LEIwaw-0/smart-parcel-locker/firmware/bsp/tft_lcd/hzfont.c

#include "hzfont.h"

/* 16x16 Chinese bitmap font generated from SimSun.
   Format: 16 rows x 2 bytes/row, MSB first, bit=1 = foreground pixel.
   Array sorted by gbk_code ascending for binary search. */
const HZFont_t HZFont[] = {
    {0xA1E6, {0x60,0x00,0x91,0xF4,0x96,0x0C,0x6C,0x04,0x08,0x04,0x18,0x00,0x18,0x00,0x18,0x00,0x18,0x00,0x18,0x00,0x18,0x00,0x08,0x00,0x0C,0x04,0x06,0x08,0x01,0xF0,0x00,0x00}}, /* gbk=0xA1E6 */
    {0xA3AC, {0x00,0x00,0x00,0x00,0x00,0x00,0x00,0x00,0x00,0x00,0x00,0x00,0x00,0x00,0x00,0x00,0x00,0x00,0x00,0x00,0x00,0x00,0x30,0x00,0x30,0x00,0x10,0x00,0x20,0x00,0x00,0x00}}, /* gbk=0xA3AC */
    {0xB0B4, {0x10,0x40,0x10,0x20,0x10,0x20,0x13,0xFE,0xFA,0x02,0x14,0x44,0x10,0x40,0x1B,0xFE,0x30,0x88,0xD0,0x88,0x11,0x08,0x10,0xD0,0x10,0x20,0x10,0x50,0x50,0x88,0x23,0x04}}, /* gbk=0xB0B4 */
    {0xB0CB, {0x00,0x00,0x00,0x40,0x04,0x40,0x04,0x40,0x04,0x40,0x04,0x40,0x04,0x40,0x04,0x20,0x08,0x20,0x08,0x20,0x08,0x10,0x10,0x10,0x10,0x08,0x20,0x08,0x20,0x04,0x40,0x02}}, /* gbk=0xB0CB */
    {0xB0D7, {0x01,0x00,0x02,0x00,0x04,0x00,0x3F,0xF8,0x20,0x08,0x20,0x08,0x20,0x08,0x20,0x08,0x3F,0xF8,0x20,0x08,0x20,0x08,0x20,0x08,0x20,0x08,0x20,0x08,0x3F,0xF8,0x20,0x08}}, /* gbk=0xB0D7 */
    {0xB0DC, {0x00,0x40,0x7C,0x40,0x44,0x40,0x54,0x80,0x54,0xFE,0x55,0x08,0x56,0x88,0x54,0x88,0x54,0x88,0x54,0x50,0x54,0x50,0x10,0x20,0x28,0x50,0x24,0x88,0x45,0x04,0x82,0x02}}, /* gbk=0xB0DC */
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
    int lo = 0, hi = HZFont_Count - 1;
    while (lo <= hi) {
        int mid = (lo + hi) / 2;
        if (HZFont[mid].gbk_code == gbk_code) return HZFont[mid].bits;
        if (HZFont[mid].gbk_code < gbk_code) lo = mid + 1;
        else hi = mid - 1;
    }
    return 0;
}
