LEIwaw-0/smart-parcel-locker/firmware/app/app_cloud.c

/******************************************************
**  app_cloud.c - TCP link to the locker server (port 8090).
**
**  Split out of the monolithic main.c; the parsing is unchanged.  Only
**  the transport moved: every uplink line is posted to the link task
**  instead of being written to the ESP8266 from here, and the door mask
**  now comes from the door task's g_door_fb snapshot.
******************************************************/
#include "app_cloud.h"
#include "app_ctx.h"
#include "app_rtos.h"
#include "app_door.h"     /* DoOpenBox */
#include "app_ui.h"       /* StatusBar_Set, PickupDone_Draw */
#include "app_voice.h"    /* Chat_HandleResponse */
#include "codebox.h"
#include "esp8266.h"
#include "lock.h"
#include <stdio.h>
#include <string.h>

void Cloud_Queue(const char *line)
{
    App_LinkPost(line);
}

static void Cloud_SendStatus(void)
{
    char line[160];
    char snap[80];
    char cbuf[8];
    uint8_t i, o = 0, occ = 0, door = 0;
    CodeEntry e;

    for (i = 1; i <= BOX_COUNT; i++)
    {
        if (CodeBox_GetEntry(i, &e))
        {
            occ |= (uint8_t)(1u << (i - 1));
            memcpy(cbuf, e.code, CODE_LEN);
            cbuf[CODE_LEN] = 0;
        }
        else
        {
            strcpy(cbuf, "------");
        }
        /* 门磁: 1=开. I2C读失败按“关”处理, 避免误报门开 */
        if ((g_door_fb >> (i - 1)) & 1u) door |= (uint8_t)(1u << (i - 1));
        if (i > 1) snap[o++] = '|';
        o += (uint8_t)sprintf(snap + o, "%d:%s", (int)i, cbuf);
    }
    snap[o] = 0;
    sprintf(line, "STATUS %d %d %s", (int)occ, (int)door, snap);
    Cloud_Queue(line);
    printf("[CLOUD] %s\r\n", line);
}

static void Cloud_RemoteOpen(uint8_t box)
{
    s_res_box  = box;
    s_res_ok   = 1;
    DoOpenBox(box, SRC_TOUCH, 3);
    StatusBar_Set(SRC_TOUCH, box, "\xD2\xD1\xBF\xAA\xCB\xF8");   /* 已开锁: all glyphs in HZFont */
    s_overlay   = 0;
    s_chat_mode = 0;
    s_state = ST_PICKUP_DONE;
    PickupDone_Draw();
    printf("[CLOUD] remote open box %d\r\n", (int)box);
}

void Cloud_HandleLine(const char *line)
{
    const char *p;
    uint8_t kind;      /* 1=OPEN/UNLOCK, 2=SET, 3=CLEAR */
    int b = 0;

    if (strncmp(line, "AI:", 3) == 0)
    {
        if (s_chat_mode) Chat_HandleResponse(line);
        return;
    }
    if (strncmp(line, "OPEN ", 5) == 0)        { p = line + 5; kind = 1; }
    else if (strncmp(line, "UNLOCK ", 7) == 0) { p = line + 7; kind = 1; }
    else if (strncmp(line, "SET ", 4) == 0)    { p = line + 4; kind = 2; }
    else if (strncmp(line, "CLEAR ", 6) == 0)  { p = line + 6; kind = 3; }
    else { printf("[CLOUD] unknown downlink: %s\r\n", line); return; }

    while (*p >= '0' && *p <= '9') { b = b * 10 + (*p - '0'); p++; }
    if (b < 1 || b > BOX_COUNT) { printf("[CLOUD] bad box: %s\r\n", line); return; }

    if (kind == 2)
    {
        char code[8];
        uint8_t n = 0, i;
        uint8_t cb[CODE_LEN];
        while (*p == ' ') p++;
        while (*p && *p != ' ' && n < CODE_LEN) code[n++] = *p++;
        code[n] = 0;
        if (n != CODE_LEN) { printf("[CLOUD] SET bad code: %s\r\n", line); return; }
        for (i = 0; i < CODE_LEN; i++) cb[i] = (uint8_t)code[i];
        CodeBox_DirectSet((uint8_t)b, cb);
        printf("[CLOUD] SET box %d code %s\r\n", b, code);
        return;
    }
    if (kind == 3)
    {
        CodeBox_Clear((uint8_t)b);
        printf("[CLOUD] CLEAR box %d\r\n", b);
        return;
    }
    Cloud_RemoteOpen((uint8_t)b);
}

/******************************************************
**  the 2s STATUS push
**
**  Called from the UI task's deadline housekeeping.  HELLO is no longer
**  handled here: the link task sends it itself on the link-up edge, before
**  anything queued behind it.  The chat lease still wins the link, so a
**  STATUS never kicks a CHAT: reply out of the way.
******************************************************/
void Cloud_StatusTick(void)
{
    if (s_chat_mode || g_chat_busy) return;
    if (!g_link_up) return;
    if (g_link_fetch) return;   /* the link is borrowed: do not spam q_link */
    Cloud_SendStatus();
}
