LEIwaw-0/smart-parcel-locker/(commit log)

2026-10-16 初始化：智能快递柜系统作品集版
    STM32F407VE 四格口智能快递柜，含柜机固件与云端平台两部分。
    固件按职责拆成 7 个应用模块（原为 2265 行单文件 main.c），
    云端为 FastAPI + SQLite，配 Web 管理后台。
    - 固件：Keil MDK 工程，自包含可独立编译（实测 0 error / 0 warning）
    - 云端：TCP 8090 与柜机长连接；Web 后台支持格口监控、远程开锁、取件码查询
    - 配置：提供 cloud/config.example.json 模板，真实 config.json 不入库
    - 演示视频体积过大，改由 Release 附件分发
    [app_clock.c, app_clock.h, app_cloud.c, app_cloud.h, app_config.h]
2026-10-16 源码编码统一为 UTF-8，修复 GitHub 网页乱码
    固件源码原为 GBK，GitHub 按 UTF-8 渲染导致网页上中文全成乱码。
    现统一转为 UTF-8，界面中文字符串改为 "\xXX" 十六进制转义保存原始 GBK
    字节，使字面量编译后的字节与原版完全一致 —— 网页可读，固件行为不变。
    - 转换 23 个文件；lcd.c/lcd.h 等 4 个文件未有改动（其损坏字符系此前
    某次编码转换所致，非本次引入）
    - 校验：字面量编译字节逐字符比对一致；Keil 编译 0 error / 0 warning
    - 验证：转换前后固件 hex 逐字节相同（sha256 一致，138688 字节 0 差异）
    [app_clock.c, app_cloud.c, app_ctx.c, app_door.c, app_flow.c, app_ui.c, app_voice.c]
2026-10-16 删除含损坏字符的注释块
    5 个文件残留 795 处 U+FFFD 替换字符，系更早一次编码事故造成的数据丢失
    （非本次引入），全部位于注释内。虽不影响编译与运行，但网页上无法阅读。
    现删除这 233 个含损坏字符的注释块。
    安全性验证：
    - 非注释内容（代码 + 字符串字面量）剔除空白后逐字节不变
    - Keil 编译 0 Error / 0 Warning
    - 固件 hex 与删除前完全一致（sha256 相同，138688 字节 0 差异）
    [esp8266.c, esp8266.h, lcd.c, lcd.h]
2026-10-16 WiFi 凭证与部署参数外置到 .gitignore 忽略的本地配置
    原先 driver/esp8266.h 里硬编码了 WiFi 名称、密码和服务器 IP，而本仓库是公开
    仓库，凭证会随代码一起发布。现移入 driver/wifi_config.h，该文件已被 .gitignore
    忽略，仓库只保留模板 driver/wifi_config.example.h。
    - esp8266.h 改为 include wifi_config.h（AC5 不支持 __has_include，故采用标准做法：构建前复制模板并填写）
    - 编译 0 Error / 0 Warning；固件 hex sha256 与改动前完全一致
    - 已实测：模拟全新克隆（只有模板、无私有配置）复制模板后同样 0 Error / 0 Warning
    - README 补充首次构建步骤与目录说明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
    [esp8266.h, wifi_config.example.h]
2026-10-19 接入 FreeRTOS：超级循环升级为 7 任务 + 队列/互斥的事件驱动架构
    内核按 V202212.01 源码 vendor 进仓库（freertos/，ARM_CM4F 移植层 + heap_4），
    应用层由"每 5ms 轮询一次"改为事件驱动：
    - 新增 app_rtos.c/h：事件结构与 IPC（q_ui/q_link/q_clock/q_door + m_lcd），
    7 个任务的创建与诊断任务；投递一律非阻塞，满则丢弃并计数
    - 新增 app_ui_task.c：UI 任务只收事件后取 LCD 锁再重绘，
    用 xQueueReceive 的 50ms 超时推进 2s 上报/25s 对话租期等截止时间
    - 新增 app_link.c：ESP8266 AT/TCP 独立成任务，天气抓取走后端借链路
    - 新增 hooks.c：configASSERT / 栈溢出 /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
2026-10-19 修复抓天气抢占链路的时序缺陷：发送未结束时不借链路
    借链路抓天气的第一步是 AT+CIPCLOSE，用来腾出 ESP8266 唯一的那个
    socket。但 FetchStart 原先只检查 ESP8266_IsReady()，而该函数在
    ES_SEND_PROMPT / ES_SEND_DATA 这两个"模块正等 AT+CIPSEND 载荷字节"
    的状态下同样返回 1。于是上行 STATUS 发到一半时启动抓天气，
    AT+CIPCLOSE 会被模块当成 TCP 载荷吐给服务器（服务器日志里出现过
    `未识别指令: 'AT+CIPCLOSE'` 与 `WinError 10054`），模块随即进入
    混乱态，后续 AT+CIPSTART 连续返回 ERROR，柜机要重跑整轮握手才
    能重新上线，网页在那几十秒里只能看到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
    [esp8266.c]
2026-10-19 README：补第 16 条踩坑(抓天气的 AT 命令泄漏)并同步编译数字
    这次修复已在硬件上验证通过：链路连续稳定，[CLOUD] STATUS 每 2s 一条，
    每次 AT+CIPSEND=47 都 SEND OK，不再出现 CIPSTART ERROR 与重新握手。
    按仓库惯例把这一个坑写进第六节，并把它带来的 Code 增量反映到
    第五节的编译结果与 7.7 代价表：49988 -> 50008。
